Shibi404/esp32-hybrid-wsn/docs/ARCHITECTURE.md

# System Architecture

**23CSE341 WSN — Lab Evaluation 2** · deliverable: *Architecture diagram*

---

## 1. System overview

```
┌──────────────────────────────────────────────────────────────────────────────┐
│                      HYBRID BLE + Wi-Fi SENSOR NETWORK                       │
├──────────────────────────────────────────────────────────────────────────────┤
│                                                                              │
│   N1  SENSOR                N2  SENSOR / RELAY         N3  CLUSTER HEAD      │
│   ┌──────────────┐          ┌──────────────┐          ┌──────────────────┐   │
│   │ DHT22        │          │ MQ2          │          │ MQ135            │   │
│   │ temp + hum   │          │ smoke / LPG  │          │ air quality      │   │
│   ├──────────────┤          ├──────────────┤          ├──────────────────┤   │
│   │ BLE  mobile  │          │ BLE  anchor  │          │ BLE  anchor      │   │
│   │ trilaterates │          │              │          │                  │   │
│   │ itself       │          │              │          │ TDMA scheduler   │   │
│   ├──────────────┤          ├──────────────┤          │ time master      │   │
│   │ CSMA/CA      │          │ CSMA/CA      │          │ AGGREGATOR       │   │
│   │ TDMA slot 1  │          │ TDMA slot 2  │          │ ROUTER           │   │
│   │ originates   │          │ originates   │          │ TDMA slots 0, 4  │   │
│   │ data         │          │ + RELAYS     │          │                  │   │
│   └──────┬───────┘          └──────┬───────┘          └────────┬─────────┘   │
│          │                         │                           │             │
│          │   unicast + ACK         │   unicast + ACK           │ aggregated  │
│          └────────────┬────────────┘                           │ unicast     │
│                       ▼                                        ▼             │
│                  ╔═════════════════════════════════════════════════════╗     │
│                  ║            N4   SINK / GATEWAY                      ║     │
│                  ║  HC-SR501 motion  ·  BLE anchor  ·  never sleeps    ║     │
│                  ║  metrics: PDR, loss, delay, throughput, retx        ║     │
│                  ║  SoftAP "WSN_SINK"  →  http://192.168.4.1           ║     │
│                  ╚═════════════════════════════════════════════════════╝     │
│                                                                              │
│   ◀══ broadcast: BEACON/schedule (N3), ROUTE_UPDATE (any), NET_STATUS (N4)   │
└──────────────────────────────────────────────────────────────────────────────┘
```

---

## 2. Protocol stack

Everything above the radio is implemented in this project. Nothing in the
shaded band is inherited from a library — that is the point of the exercise.

```
  ┌─────────────────────────────────────────────────────────────────┐
  │  APPLICATION   sensing · alarms · dashboard · metrics           │
  │                wsn_sensors · wsn_metrics · dashboard_html       │
  ├─────────────────────────────────────────────────────────────────┤
  │  AGGREGATION   min/max/mean fusion, alarm OR, data reduction    │ ░
  │                wsn_aggregate                                    │ ░
  ├─────────────────────────────────────────────────────────────────┤
  │  NETWORK       neighbour table · 5-parameter cost metric ·      │ ░
  │                failure detection · alternate route · recovery   │ ░
  │                wsn_route                                        │ ░
  ├─────────────────────────────────────────────────────────────────┤
  │  SCHEDULING    TDMA superframe · dynamic slot grant/revoke ·    │ ░
  │                beacon time sync · sleep/wake                    │ ░
  │                wsn_tdma                                         │ ░
  ├─────────────────────────────────────────────────────────────────┤
  │  MAC           CCA (physical + NAV) · DIFS · random backoff     │ ░
  │                with freeze · ACK · timeout · BEB · retry limit  │ ░
  │                wsn_mac                                          │ ░
  ├─────────────────────────────────────────────────────────────────┤
  │  FRAMING       21-byte header · CRC-16 · path list · NAV field  │ ░
  │                wsn_protocol                                     │ ░
  ├═════════════════════════════════════════════════════════════════┤
  │  TRANSPORT     ESP-NOW  (802.11 vendor action frames)           │  ← vendor
  │  RADIO         ESP32 2.4 GHz · one radio, shared with BLE       │  ← silicon
  └─────────────────────────────────────────────────────────────────┘

        BLE side (parallel, time-multiplexed onto the same radio):
  ┌─────────────────────────────────────────────────────────────────┐
  │  LOCALIZATION  median → EWMA → log-distance → trilateration →   │ ░
  │                error / RMSE · nearest-node proximity            │ ░
  │                wsn_ble                                          │ ░
  ├═════════════════════════════════════════════════════════════════┤
  │  BLE GAP       advertising + active scanning (Bluedroid)        │  ← vendor
  └─────────────────────────────────────────────────────────────────┘
```

---

## 3. Why the two radios are time-multiplexed

The ESP32 has **one** 2.4 GHz radio shared between Wi-Fi and Bluetooth.

Advertising is a short burst every few tens of milliseconds and coexists with
Wi-Fi without trouble. **Scanning** is a continuous receive, and that is what
genuinely conflicts on a shared radio — it both starves the scan window and
biases the RSSI the localization depends on. The split follows from that:

* **Every node advertises, always.** That is what makes an anchor an anchor:
  discoverable whenever somebody looks. It also removes a phase-alignment
  problem — boards booted at different times would otherwise drift into
  different phases and a scan could find no anchors at all.
* **Only N1 and N2 scan**, pausing their network participation to do it. This
  matches the node table in the brief exactly, where BLE is listed against N1
  and N2 but not against the cluster head or the sink.
* **N3 and N4 never scan.** N3 is the time master and scheduler — blocking it
  for three seconds would stop the whole superframe. N4 must keep serving the
  dashboard.

A scanning node is off the air for about 3 s, roughly 1.5 superframes. The
slot-revocation threshold is 4 superframes, comfortably clear of it, and the
node waits for its transmit queue to drain before it leaves, so no frame is
abandoned mid-handshake.

N1 and N2 therefore alternate two phases, which is also the demonstration
sequence the guidelines specify:

```
   ┌── PHASE A · BLE scan ───────────── ~3.5 s ─┐
   │  active scan (advertising never stopped)    │
   │  RSSI samples → median → EWMA               │
   │  log-distance path loss → distance          │
   │  trilateration → (x, y) → error, RMSE       │
   │  BLE RSSI handed to the routing metric      │
   └──────────────────┬──────────────────────────┘
                      ▼
   ┌── PHASE B · Wi-Fi ──────────────── ~30 s ──┐
   │  beacon + schedule + time sync              │
   │  CSMA/CA → TDMA slot → unicast + ACK        │
   │  aggregation at N3                          │
   │  multi-hop → sink                           │
   │  metrics, dashboard, sleep slots            │
   └──────────────────┬──────────────────────────┘
                      └──────► back to Phase A
```

Both stacks stay **initialised** throughout — ESP-NOW peers, the sink's SoftAP
and BLE advertising all persist. Only the scan comes and goes.

N3 and N4 have no Phase A at all: the cluster head must keep the superframe
running and the sink must keep the dashboard reachable. A mains-powered
gateway trades energy for availability, which is the usual WSN asymmetry.

---

## 4. Where BLE and Wi-Fi actually meet

A common weakness in a "hybrid" design is that the two halves never interact —
BLE is demonstrated, then Wi-Fi is demonstrated, and nothing connects them.
Here there are three real couplings:

| Coupling | Mechanism |
|---|---|
| **BLE RSSI → routing** | `routeNoteBleRssi()` feeds the filtered BLE RSSI into the route cost. When a neighbour's Wi-Fi RSSI is not yet known, the BLE measurement selects the next hop. |
| **Localization → sink** | N1 computes its position over BLE and reports it to the sink over Wi-Fi as an `FT_LOC` frame, so the dashboard's localization panel is fed through the Wi-Fi network. |
| **Shared radio budget** | The phase machine is itself the coupling: Wi-Fi traffic is suppressed during ranging so that RSSI is measured on a quiet medium. |

---

## 5. Frame format

```
  byte  0   1   2   3   4     5      6    7    8  9    10 11 12 13   14 15
      ┌───┬───┬───┬───┬─────┬──────┬────┬────┬──────┬────────────┬────────┐
      │MAG│VER│TYP│SRC│ DST │FINAL │HOP │TTL │ SEQ  │  txTimeMs  │durUs   │
      └───┴───┴───┴───┴─────┴──────┴────┴────┴──────┴────────────┴────────┘
       16     17 18 19 20          21 .. N              N+1  N+2
      ┌──────┬──────────────┐  ┌───────────────┐  ┌──────────────┐
      │pathLn│  path[4]     │  │    payload    │  │    CRC-16    │
      └──────┴──────────────┘  └───────────────┘  └──────────────┘
         21-byte header            type-dependent      CCITT
```

| Field | Purpose |
|---|---|
| `src` / `dst` / `finalDst` | `dst` is the **next hop**, `finalDst` the destination. Separating them is what makes multi-hop forwarding possible. |
| `hop`, `ttl` | Hop count for the metric; TTL bounds a routing loop. |
| `seq` | Per-originator sequence. The sink derives PDR and loss from gaps in it. |
| `txTimeMs` | Network time at **origination**, never re-stamped on a retry — so end-to-end delay includes the cost of retransmissions. |
| `durationUs` | NAV: how long the sender expects to hold the medium. Overhearing nodes treat the channel as busy for that long (virtual carrier sense). |
| `path[4]` | Nodes traversed. Gives the sink a printable route (`1→3→4`) and lets a forwarder drop a looping frame. |

### Frame types

| Type | Cast | Carries |
|---|---|---|
| `HELLO` | broadcast | liveness, hop count, cost, next hop, alarm, retx |
| `BEACON` | broadcast | slot map, schedule version + reason, network time |
| `ROUTE_UPDATE` | broadcast | link up/down, new next hop, new cost |
| `NET_STATUS` | broadcast | sink's PDR, loss, delay, throughput, reduction |
| `CMD` | broadcast | demonstration control |
| `DATA` | unicast | one node's sensor reading |
| `AGG` | unicast | min/max/mean across contributors + reduction counters |
| `LOC` | unicast | trilateration result → sink |
| `SLOT_REQ` | unicast | backlog / alarm report → cluster head |
| `ACK` | unicast | acknowledgement of a data-bearing frame |

This mapping is exactly what the guidelines require: control, schedule, route
and status information is **broadcast**; sensor data, next-hop traffic,
aggregated data and acknowledgements are **unicast**.

---

## 6. TDMA superframe

```
  ├──────────────────────── 2000 ms superframe ─────────────────────────┤
  │  0      │  1     │  2     │  3      │  4     │  5     │  6   │  7   │
  │ BEACON  │ DATA   │ DATA   │ DYNAMIC │ AGG    │ CAP    │STATUS│SLEEP │
  │  N3     │  N1    │  N2    │  (none) │  N3    │  all   │  N4  │  --  │
  │ 250 ms  │ 250 ms │ 250 ms │ 250 ms  │ 250 ms │ 250 ms │250ms │250ms │

  N1 awake:   ███      ███                                 ███
  N2 awake:   ███      ███      ███                        ███
  N3 awake:   ███      ███      ███       ███      ███     ███
  N4 awake:   ████████████████████████████████████████████████████████  (never sleeps)
```

Slot 3 is unassigned by default — a sleep slot. The cluster head grants it on
demand, which is what makes the schedule dynamic rather than fixed:

| Trigger | Action | Reason code |
|---|---|---|
| A node's gas/motion alarm fires | grant slot 3 to it | `ALARM_GRANT` |
| The alarm clears | return slot 3 to sleep | `ALARM_RELEASE` |
| A node reports a backlog ≥ 3 | grant slot 3 to it | `BACKLOG_GRANT` |
| A node misses 3 consecutive slots | revoke its slot | `NODE_SILENT` |
| That node transmits again | restore its slot | `NODE_REJOIN` |
| `collide` is issued | two owners in slot 5 | `COLLISION_TEST` |

Every change increments `schedVersion` and is broadcast with its reason.
Version numbering also makes adoption safe: a stale beacon overheard late can
never roll the network backwards.

---

## 7. Routing

```
   cost(neighbour) = 100·(hops+1)              ← hop count
                   + 150·(1 − rssiNorm)        ← RSSI / link quality
                   + 200·(1 − ackRate)         ← successful ACK rate
                   + 100·lossRate              ← packet loss
                   = ∞   if the link is down   ← link availability

   rssiNorm maps −95 dBm → 0 and −35 dBm → 1
   RSSI source: Wi-Fi (from the MAC sniffer), falling back to BLE
```

All five parameters the guidelines list are used. ACK rate carries the heaviest
weight because it is the most direct evidence that a link actually delivers —
RSSI can look healthy on a link that is failing.

Two further terms shape the result:

**Cluster-head preference** (`ROUTE_W_CH_BONUS`, −150). A sensor node reporting
to its head is what makes aggregation possible; routing around the head would
deliver the same readings in three times as many packets. It is a discount
rather than a hard rule, so once the head's link degrades the arithmetic lets
an ordinary neighbour win. Same idea as LEACH's cluster-member behaviour.

**Topology constraint** (`ROUTE_LINK_ALLOWED`). On a bench every board hears
every other, so each node could reach the sink in one hop and the multi-hop,
aggregation and recovery paths would never execute. The matrix declares the
intended deployment topology — N1 has no direct link to the sink. This is a
routing policy, stated openly, not a claim about radio range; spacing the nodes
down a corridor produces the same topology physically, and setting every entry
to 1 lets the cost metric discover it unaided.

### Failure and recovery

```
   1. LINK FAILURE        N3 powered off, or `fail 3`
            │
   2. DETECTION           3 consecutive ACK losses   ──or──  7 s of silence
            │             (catches links we transmit on)  (catches a dead node
            │                                              we never send to)
            ▼
   3. ROUTE UPDATE        cost(N3) := ∞ ; broadcast ROUTE_UPDATE
            │
   4. ALTERNATE SELECTED  next-lowest cost wins:  N1 → N2 → N4
            │
   5. DELIVERY CONTINUES  sink keeps receiving; path list now reads 1→2→4
            │
   6. RECOVERY            N3 heard again → link marked up → costs recomputed →
                          the original path wins back on merit, not by force
```

The two detectors exist because they catch different failures. Failover
latency (step 2 → step 4) is measured and reported.

---

## 8. Module map

| Module | Responsibility | Lab requirement served |
|---|---|---|
| `wsn_config` | MACs, coordinates, pins, all tuning | Setup, addressing |
| `wsn_protocol` | Frame format, CRC, path handling | Addressing, broadcast/unicast |
| `wsn_log` | Human + CSV output streams | Screenshots, performance data |
| `wsn_sensors` | DHT22/MQ2/MQ135/PIR, warm-up, calibration, faults | Sensing |
| `wsn_ble` | Advertise, scan, filter, range, trilaterate | **BLE localization (3)** |
| `wsn_mac` | CCA, NAV, DIFS, backoff, ACK, BEB, retry | **Wi-Fi MAC (3)** |
| `wsn_tdma` | Superframe, dynamic slots, time sync, sleep | **Scheduling (2)** |
| `wsn_route` | Neighbour table, cost, failure, recovery | **Routing (2)** |
| `wsn_aggregate` | Min/max/mean fusion, reduction accounting | **Aggregation (2)** |
| `wsn_metrics` | PDR, loss, delay, throughput, retx, reduction | **Performance (2)** |
| `wsn_node` | Phase machine, slot actions, frame dispatch | Integration |
| `wsn_cli` | Serial command interface | Demonstration |
| `dashboard_html` | Seven-panel live dashboard | **Dashboard** |

---

## 9. Mermaid source (for the report)

```mermaid
graph LR
  subgraph BLE["BLE phase — localization"]
    A2[N2 anchor]:::anc
    A3[N3 anchor]:::anc
    A4[N4 anchor]:::anc
    M1[N1 mobile]:::mob
    A2 -. RSSI .-> M1
    A3 -. RSSI .-> M1
    A4 -. RSSI .-> M1
  end

  subgraph WIFI["Wi-Fi phase — ESP-NOW, channel 1"]
    N1[N1 · DHT22<br/>sensor]:::sen
    N2[N2 · MQ2<br/>sensor + relay]:::sen
    N3[N3 · MQ135<br/>cluster head]:::ch
    N4[N4 · PIR<br/>sink + dashboard]:::sink
    N1 -->|unicast DATA + ACK| N3
    N2 -->|unicast DATA + ACK| N3
    N3 -->|unicast AGG + ACK| N4
    N1 -.->|alternate route| N2
    N2 -.->|alternate route| N4
    N3 ==>|broadcast BEACON / schedule| N1
    N3 ==>|broadcast BEACON / schedule| N2
    N4 ==>|broadcast NET_STATUS| N3
  end

  M1 -->|FT_LOC over Wi-Fi| N4

  classDef anc  fill:#1f3350,stroke:#58a6ff,color:#e6edf3
  classDef mob  fill:#3d3417,stroke:#d29922,color:#e6edf3
  classDef sen  fill:#16281c,stroke:#3fb950,color:#e6edf3
  classDef ch   fill:#1f3350,stroke:#58a6ff,color:#e6edf3
  classDef sink fill:#3d1418,stroke:#f85149,color:#e6edf3
```
