Shibi404/esp32-hybrid-wsn/(commit log)

2026-10-08 chore: initialise repository scaffolding
    Set up the project structure for the 4-node hybrid BLE + Wi-Fi WSN:
    folder layout for shared firmware modules, the four node sketches,
    host-side tools and documentation.
    README documents the node/sensor allocation, the BLE/Wi-Fi phase
    separation that works around the ESP32's single 2.4 GHz radio, build
    settings (Huge APP partition is mandatory), the demonstration sequence
    and the seven performance metrics.
2026-10-08 feat(common): add configuration, addressing and wire protocol
    wsn_config: every deployment-specific value in one place -- the node MAC
    table, tape-measured anchor coordinates, GPIO map, MQ conditioning
    constants, MAC/TDMA/routing tuning. NODE_ID and NODE_ROLE are runtime
    externs rather than defines so that common/*.cpp stays byte-identical
    across all four sketches (Arduino compiles each .cpp separately, so an
    .ino define would not reach them).
    wsn_protocol: packed 21-byte header carrying separate next-hop and final
    destination (multi-hop), a traversed-path list (route display plus loop
    detection), a NAV duration field for virtual carrier sense, and a network
    timestamp for end-to-end delay.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
2026-10-08 feat(sensors): add DHT22/MQ2/MQ135/PIR driver with warm-up and calibration
    One sensor per board, selected at runtime from NODE_ID so the module
    compiles identically into all four sketches.
    Warm-up: MQ readings during the 120 s pre-heat are flagged WARMING rather
    than suppressed, so the network keeps running and the dashboard shows an
    honest state instead of a plausible lie.
    Calibration: R0 is measured in clean air and persisted to NVS. Auto-
    calibration deliberately runs at the *end* of warm-up, not at boot --
    calibrating a cold heater would bake a wrong baseline into flash. ppm is
    clamped to the datasheet's usable span so an extrapolated log-log fit
    cannot skew the aggregator's averages.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
    [wsn_sensors.cpp, wsn_sensors.h]
2026-10-08 feat(ble): add advertising, scanning, RSSI ranging and trilateration
    Full localization chain: advertise + active scan -> per-neighbour RSSI
    samples -> median -> EWMA -> log-distance path loss -> distance ->
    least-squares trilateration -> localization error with running mean and
    RMSE. Nearest-node proximity is reported separately so a result still
    exists when fewer than three anchors are heard.
    Median before EWMA is deliberate: BLE RSSI on a busy 2.4 GHz band throws
    occasional 15-20 dB multipath outliers that drag a mean but not a median;
    the EWMA then stops the position jittering between rounds.
    Trilateration subtracts the reference anchor's circle equation to cancel
    the quadratic terms, t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
    [wsn_ble.cpp, wsn_ble.h]
2026-10-08 feat(mac): add CSMA/CA with carrier sense, backoff, ACK and retransmission
    An application-layer MAC on top of ESP-NOW, implemented deliberately
    rather than relying on the 802.11 CSMA/CA already in silicon -- the point
    is to make every decision observable, so each carrier-sense result,
    backoff draw, freeze, ACK timeout and contention-window doubling is logged
    and counted.
    Carrier sense uses two independent mechanisms OR-ed together: physical CCA
    from a promiscuous-mode sniffer (medium busy for a window after any frame
    above the RSSI threshold) and virtual carrier sense from a NAV set by the
    durationUs field every WSN frame carries. The sniffer also harvests
    per-peer Wi-Fi RSSI by parsing add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
2026-10-08 feat(tdma): add dynamic superframe scheduling with sleep/wake
    8 slots x 250 ms superframe with the cluster head as time master. Its
    beacon carries both the superframe origin and its own clock, giving every
    node a shared network time -- which is what makes slot boundaries agree
    across boards and lets the sink compute a true end-to-end delay from a
    timestamp written by a different ESP32.
    The schedule is genuinely dynamic, driven by demand rather than by a
    timer. Slot 3 is unassigned (and therefore a sleep slot) until a node
    raises a sensor alarm or reports a backlog, at which point the head grants
    it; when the alarm clears the slot returns to sleep. A node that misses
    its slots has it revoked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
2026-10-08 feat(routing): add neighbour table, cost metric, failure detection and recovery
    Route cost combines all five parameters the guidelines list -- hop count,
    RSSI/link quality, ACK success rate, packet loss, and link availability as
    an infinite cost. The RSSI input prefers the Wi-Fi RSSI measured by the
    MAC sniffer and falls back to the BLE RSSI from the localization phase,
    which is the concrete point where the BLE half of the system feeds the
    Wi-Fi half rather than the two running as separate demos.
    Two independent failure detectors, because they catch different failures:
    consecutive ACK losses catch a peer we are actively transmitting to, and a
    silence timeout catches a neighbour that was pow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
    [wsn_route.cpp, wsn_route.h]
2026-10-08 feat(metrics): add performance measurement and cluster-head aggregation
    Metrics: all seven the guidelines list, where four are required. PDR and
    loss come from gaps in the observed sequence span rather than from a count
    the source claims -- that is the honest definition at a receiver, because
    it makes a packet lost in transit visible even though the sink never heard
    about it. Duplicates are discarded before counting, otherwise PDR would
    read above 1.0. End-to-end delay uses the beacon-synchronised clock and
    discards samples taken before the clocks converge instead of folding them
    in as zero.
    Aggregation: one superframe's readings from N1, N2 and the head's own
    sensor collapse into a single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
2026-10-08 feat(node): add shared node runtime and serial CLI
    wsn_node holds the phase machine, slot actions and frame handling for all
    four roles, so the sketches stay thin and a protocol fix lands on every
    node at once instead of being copied three times and then diverging.
    The phase machine follows the demonstration flow literally: BLE discovery
    and localization, then Wi-Fi init, then network operation, looping so
    localization is refreshed live rather than measured once at boot. The sink
    is the exception -- it never leaves the Wi-Fi phase and only advertises,
    because a blocking 4 s BLE scan would stall the dashboard it has to keep
    serving. Wi-Fi stays up throughout so ESP-NOW peers and the SoftAP s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
    [wsn_cli.cpp, wsn_cli.h, wsn_config.h, wsn_node.cpp, wsn_node.h]
2026-10-11 feat(firmware): add the four node sketches, sink dashboard and build tools
    Each sketch is deliberately thin -- it sets its node id and role, names the
    sensor and wiring in a header comment, and hands off to the shared runtime.
    Role-specific behaviour reaches the runtime through hooks, which is how the
    sink adds its SoftAP and web server without forking the loop.
    Dashboard: seven panels matching the guidelines (node status, BLE
    localization with a to-scale map of anchors vs estimated vs true position,
    sensor data, routing path drawn as a live topology graph, aggregation,
    MAC activity, performance) plus a slot map and demonstration buttons. It
    is embedded as PROGMEM rather than uploaded to SP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
2026-10-11 feat(tools): add serial capture and report-graph generation
    serial_logger picks the "#CSV," rows out of the same console the demo is
    narrated on -- no second UART needed -- and splits them into one CSV per
    record type. An unrecognised record type is written with generic column
    names rather than discarded, so a later firmware change cannot silently
    lose data mid-experiment.
    plot_metrics turns a capture into the six figures and the results table
    the report needs: PDR and loss over time, delay histogram plus time
    series, throughput, backoff distribution against contention-window growth,
    localization error per round with estimated-vs-true scatter, and
    cumulative bytes with and without aggregati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
    [plot_metrics.py, serial_logger.py]
2026-10-11 docs: add wiring, architecture and flowchart deliverables
    WIRING leads with the two mistakes that cost hardware: the blue trimpot on
    an MQ breakout drives the LM393 comparator for DOUT and does not attenuate
    AOUT at all, and ADC2 is unusable while Wi-Fi runs so both MQ analog pins
    must sit on ADC1. It also states plainly what running the MQ heaters at
    3.3 V costs -- reduced sensitivity and untrustworthy absolute ppm, with
    relative response intact -- rather than quietly presenting indexed values
    as calibrated ones, and gives the 5 V + divider upgrade path.
    ARCHITECTURE documents the stack with the vendor boundary marked, so it is
    clear which layers are implemented here. It also names the thr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
2026-10-11 docs: add demonstration script, viva preparation and results templates
    DEMO_SCRIPT walks the exact sequence the brief specifies, with the serial
    output to expect at each step and the explanation to give, plus a
    pre-demo checklist and a symptom/cause/fix table. It flags the trap that
    a sagging USB supply shows up in results as fake packet loss.
    VIVA_QA answers the likely questions against specific code, and includes
    an "awkward questions" section stating the real limitations plainly: the
    ppm figure is not trustworthy at a 3.3 V heater voltage, the collision
    demo stages the timing but not the mechanism, three anchors give no
    redundancy, and RSSI ranging is the weakest link in the system. A kn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
2026-10-11 docs: add the technical report and a .docx generator
    TECHNICAL_REPORT covers objective, node configuration, hardware, protocol
    design, and one section per graded mechanism, with a requirement-coverage
    appendix mapping every rubric line to where it is implemented.
    It explains the reasoning behind each design decision rather than only
    describing the result: why the radios are time-multiplexed, why the
    backoff freezes instead of restarting, why aggregation sends min and max
    alongside the mean, why ACK rate carries the heaviest routing weight, and
    why PDR is derived from sequence gaps. Section 13 states the limitations
    outright -- gas ppm is indicative rather than calibrated at a 3.3 V heater
    v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
2026-10-11 fix: make all four sketches compile warning-free on arduino-esp32 3.0.1
    Verified with arduino-cli against the installed core. All four build with
    --warnings all and no diagnostics: N1-N3 at 1.72 MB flash / 59.7 kB RAM,
    N4 at 1.79 MB / 61.3 kB. That confirms the Huge APP partition is genuinely
    required -- the default 1.2 MB app partition would reject every one of
    them -- and that BLE, ESP-NOW, SoftAP and the web server do fit together
    on the sink with 266 kB of RAM to spare.
    BLE scan callback: the signature changed partway through the 3.x series,
    so a guard on ESP_ARDUINO_VERSION_MAJOR was wrong -- 3.0.1 still takes
    BLEAdvertisedDevice by value while later 3.x takes a pointer. Declaring
    both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
    [Node4_Sink.ino, wsn_ble.cpp, wsn_config.h, wsn_mac.cpp, wsn_sensors.cpp, wsn_tdma.cpp]
2026-10-11 fix(routing): make multi-hop and failure detection actually happen
    Two behavioural bugs that would have made the demonstration hollow, both
    invisible to the compiler.
    routeNextHop() short-circuited to the destination whenever it was a known
    healthy neighbour. On a bench every board hears the sink, so every node
    would have delivered in one hop and the multi-hop forwarding, cluster-head
    aggregation and route-recovery paths would never have executed at all.
    Traffic for the sink now always follows the computed route, and a new
    ROUTE_LINK_ALLOWED matrix declares the topology the deployment is meant to
    have (N1 has no direct link to the sink). That is a routing policy, stated
    openly in the README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
    [wsn_cli.cpp, wsn_config.cpp, wsn_config.h, wsn_node.cpp, wsn_route.cpp]
2026-10-11 fix(ble): separate advertising from scanning so localization can work
    The BLE phases were never aligned between boards. Each node ran its own
    free-running cycle from its own boot time, and a node that stopped
    advertising while in its Wi-Fi phase was invisible. A scanner could
    therefore find one anchor, or none, and trilateration would simply never
    produce a result -- the 3-mark component, silently dead.
    The fix follows from which half of BLE actually conflicts with Wi-Fi.
    Advertising is a ~1 ms burst every few tens of milliseconds and coexists
    fine; scanning is a continuous receive and is what starves the scan window
    and biases RSSI. So every node now advertises permanently -- which is also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
    [wsn_config.h, wsn_node.cpp]
2026-10-11 fix(metrics,ble): correct PDR accounting, anchor scanning and LOC delivery
    Three defects that would have produced wrong or missing numbers.
    PDR was understated badly. Every frame drew from one sequence counter, so a
    source's HELLOs and beacons consumed sequence numbers the sink never counts
    as delivered; the sequence span therefore implied several losses before each
    data frame. Data-bearing frames now have their own sequence space. Only one
    unicast is in flight per node, so the two spaces cannot make an ACK
    ambiguous.
    The per-source table was also empty for the sensor nodes, because once
    aggregation works their raw packets stop at the cluster head by design and
    never reach the sink -- so d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
    [wsn_ble.cpp, wsn_mac.cpp, wsn_metrics.cpp, wsn_metrics.h, wsn_node.cpp]
2026-10-11 fix(tdma): re-register ESP-NOW peers after every radio wake
    esp_wifi_stop() during a sleep slot can tear the ESP-NOW peer list down
    with it. A send to a peer that is no longer registered fails silently --
    which the MAC would see as an unacknowledged frame, and three of those
    look exactly like a link failure. A duty-cycling node could therefore have
    triggered a spurious re-route every time it woke, and the route-recovery
    demonstration would have been drowned in false positives.
    The wake path now re-registers the peers unconditionally; it is cheap and
    idempotent. The helper is also called when a node returns from its BLE
    scan, since a sleep slot may have powered the radio down just before it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
    [wsn_mac.cpp, wsn_mac.h, wsn_node.cpp, wsn_tdma.cpp, wsn_tdma.h]
2026-10-11 build: add a one-command build verifier for all four sketches
    build_all.py runs sync_common --check first, so a build can never pass
    while a sketch folder still holds a stale copy of a shared module, then
    compiles each node with warnings enabled and prints a flash/RAM table.
    It locates arduino-cli on PATH or inside an Arduino IDE 2.x installation,
    which is where it already is on a typical lab machine, so there is nothing
    extra to install.
    Verified against esp32 core 3.0.1: all four build clean, 1682 kB / 58 kB
    for the sensor and cluster-head nodes and 1745 kB / 60 kB for the sink
    with its SoftAP and web server. README records those figures.
2026-10-11 docs: add a staged bring-up and testing guide
    DEMO_SCRIPT is written for the examiner; this is for getting the system
    working in the first place, which is a different problem. Flashing all
    four nodes at once leaves four possible causes for any failure and no way
    to separate them, so the guide adds one variable at a time: hardware
    safety checks before power, MAC collection, sensors node by node, then
    N3+N4 for the network skeleton, then N2 for real aggregation, then N1 for
    localization.
    Each stage states its pass criterion and the specific log line to look
    for, and names what each failure mode actually means -- an MQ reading of
    raw 0 versus raw 4095, a node that transmits but is never acknow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
2026-10-11 docs,sensors: DHT22 works without an external pull-up in most setups
    The wiring guide demanded a 10 kOhm pull-up as if it were mandatory. It is
    not, and saying so was unhelpful to anyone without one in front of them.
    Three facts now stated plainly: a 3-pin DHT22 module almost always has the
    resistor fitted already; the ESP32's internal ~45 kOhm pull-up is enabled
    in firmware (sensorsBegin sets INPUT_PULLUP and the Adafruit library
    re-asserts it on every read) and is usually sufficient over a short data
    wire; and any value from 4.7k to 22k will do if an external one is needed,
    since it is not a precision component.
    The failure message now says what to try in order -- shorten the wire
    first,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
    [wsn_sensors.cpp]
2026-10-11 config: fill in the four board MAC addresses
    Assigned in the order they were read off the boards: N1 (DHT22),
    N2 (MQ2), N3 (MQ135), N4 (PIR).
    Added a note next to the table because two of these differ only in the
    final byte -- N2 ends 7A:B8 and N4 ends 7A:38. Swapping them would put the
    sink's firmware on a sensor node and produce a network that half-works in
    a confusing way. The boot banner already compares this table against each
    board's own MAC and warns on a mismatch, so the note points at that as the
    check.
    [wsn_config.cpp]
2026-10-11 fix(log): read the station MAC from eFuse, and make the banner recoverable
    The boot banner reported STA MAC 00:00:00:00:00:00 on real hardware.
    WiFi.macAddress() goes through the netif layer and returns all zeros when
    consulted before that layer is ready -- which is exactly when the banner
    runs, microseconds after WiFi.mode(). esp_read_mac() derives the same
    address from the burned-in base MAC and works whether or not the driver
    has started.
    ESP-NOW itself was unaffected, since peers are addressed from the
    NODE_MAC table and frames are matched on the logical node id in the
    header. What the zeros did break was the NODE_MAC consistency check: it
    compared against 0, concluded the board was abs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
    [wsn_cli.cpp, wsn_log.cpp, wsn_log.h, wsn_node.cpp]
2026-10-11 fix(tdma,route): stop duty cycling from destroying the network
    Field testing showed 86% ACK loss to the cluster head and 59% to the relay
    on links measuring -54 to -70 dBm, with 70 route changes and 79 phantom
    link failures in a few minutes. Strong links do not lose 86% of ACKs; the
    receivers were not listening.
    esp_wifi_start() needs roughly 100 ms to bring the PHY back -- 40% of a
    250 ms slot. Nodes woke on the slot boundary, the sender transmitted ~20 ms
    in, and the receiver's radio was still booting. The cluster head had it
    worst: it slept through slot 7 and then had to beacon in slot 0 with a cold
    radio, so the beacons that carry the schedule and the time reference were
    themselves bein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
    [wsn_config.h, wsn_route.cpp, wsn_tdma.cpp]
2026-10-11 fix(tdma): stop powering down Wi-Fi while BLE is live -- it aborts
    N1 and N2 boot-looped with abort() on core 1. They are precisely the two
    nodes that both duty-cycle and advertise over BLE; N3 (which stopped
    sleeping after the previous fix) and N4 (which never sleeps) were fine.
    The ESP32 shares one radio between Wi-Fi and Bluetooth. Calling
    esp_wifi_stop() in a sleep slot tears the Wi-Fi driver down underneath a
    live BT controller, and the coexistence layer aborts.
    Radio power-down is now behind ENABLE_RADIO_SLEEP, default 0. The
    scheduler is unchanged and still does its real work: it decides which
    slots each node must be awake for, marks the rest as sleep slots, drops
    the LED and counts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
    [wsn_config.h, wsn_tdma.cpp]
2026-10-11 fix(ble): require Arduino-ESP32 3.x and bring BLE up before Wi-Fi
    N1 and N2 boot-looped with abort() on a laptop running core 2.0.x.
    Decoding the backtrace against a matching 2.0.14 build named the cause
    exactly:
    coex_core_disable <- coex_core_condition_check <- hli_intr_register
    <- triggerApbChangeCallback <- BLEDevice::getScan() <- bleBegin()
    The Wi-Fi/BT coexistence layer in 2.0.x aborts when BLE initialises while
    Wi-Fi is already running. 3.0.1 reworked that code and is unaffected,
    which is why the two nodes flashed from the 3.0.1 machine were fine and
    the two from the 2.0.x machine were not. My earlier guess that this was
    the sleep path was wrong -- it never reached l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
    [wsn_ble.cpp, wsn_config.h, wsn_node.cpp]
2026-10-11 fix: dashboard polling was costing the cluster head its ACKs
    Reported symptoms: 66% delivery ratio on links at -37 dBm, N1 flapping
    onto the alternate route, and a routing panel showing zero route changes
    while the route was visibly changing. Three separate causes.
    The sink blocks inside server.handleClient() building and sending a ~4 kB
    JSON response, and the ACKs it owes are only transmitted from macLoop(),
    which cannot run during that window. At a 60 ms deadline the cluster
    head's aggregates were timing out, being retried and finally dropped --
    appearing at the sink as sequence gaps. The ACK timeout moves to 120 ms,
    the sink runs macLoop() the instant the handler returns rather than
    wait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
    [Node4_Sink.ino, dashboard_html.h, wsn_config.h, wsn_metrics.cpp, wsn_metrics.h, wsn_node.cpp, wsn_node.h, wsn_route.cpp]
